skitzo2000/cyberdecks/backplane/a7s_backplane_schematic_kicad.png

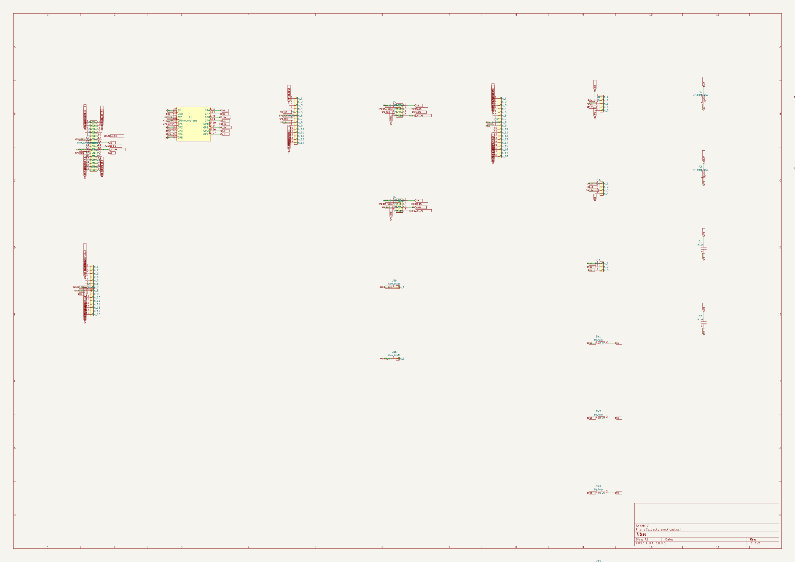
backplane/a7s_backplane_schematic_kicad.png
