skitzo2000/cyberdecks/backplane/kicad/renders/placement_current.png

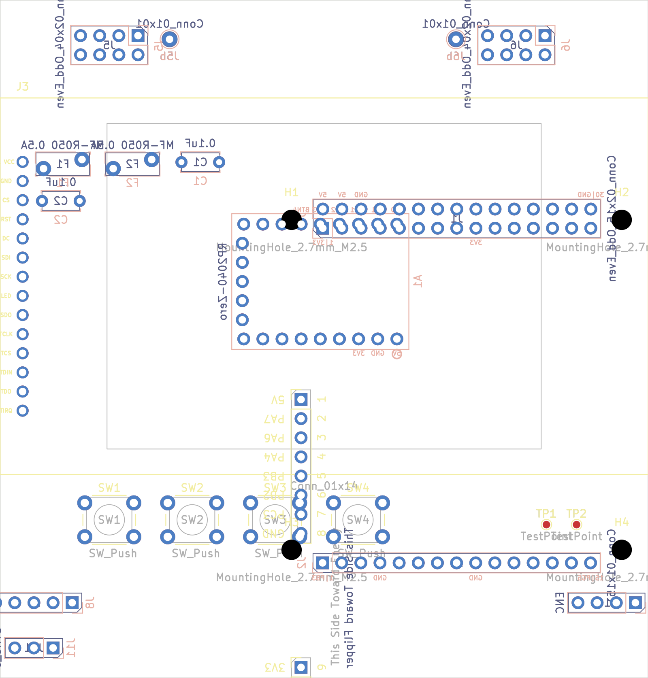
backplane/kicad/renders/placement_current.png
