skitzo2000/cyberdecks/backplane/kicad/renders/routed_bottom.png

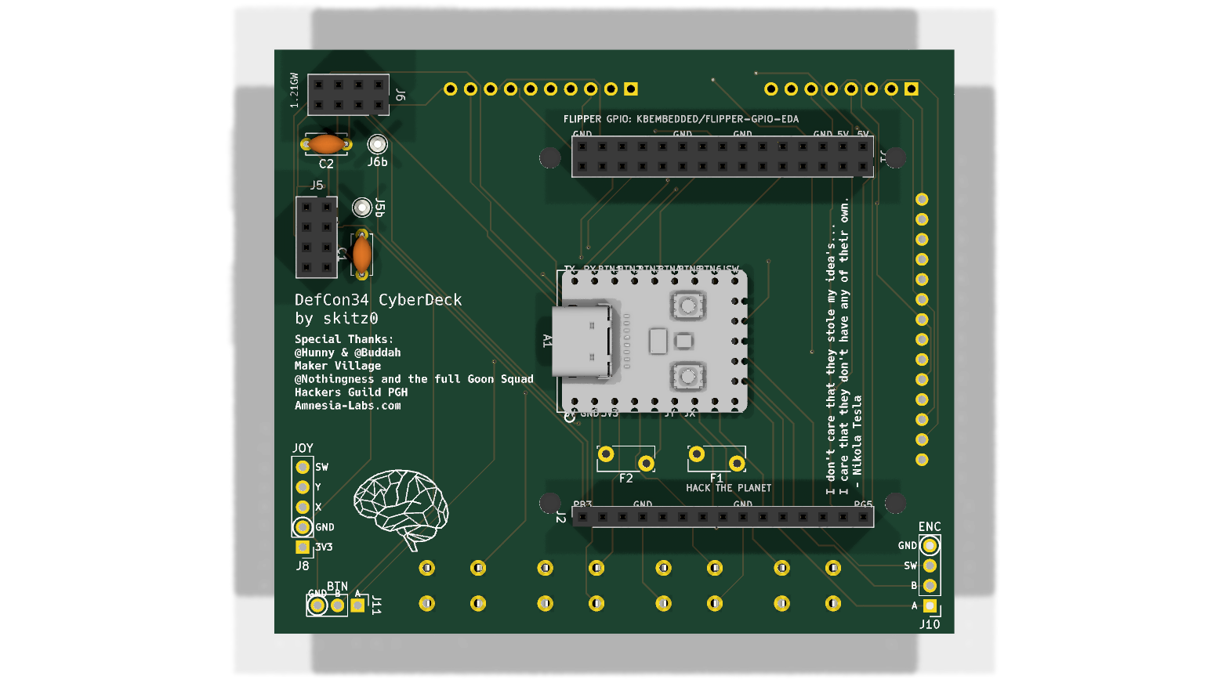
backplane/kicad/renders/routed_bottom.png
