skitzo2000/cyberdecks/backplane/kicad/renders/routed_top.png

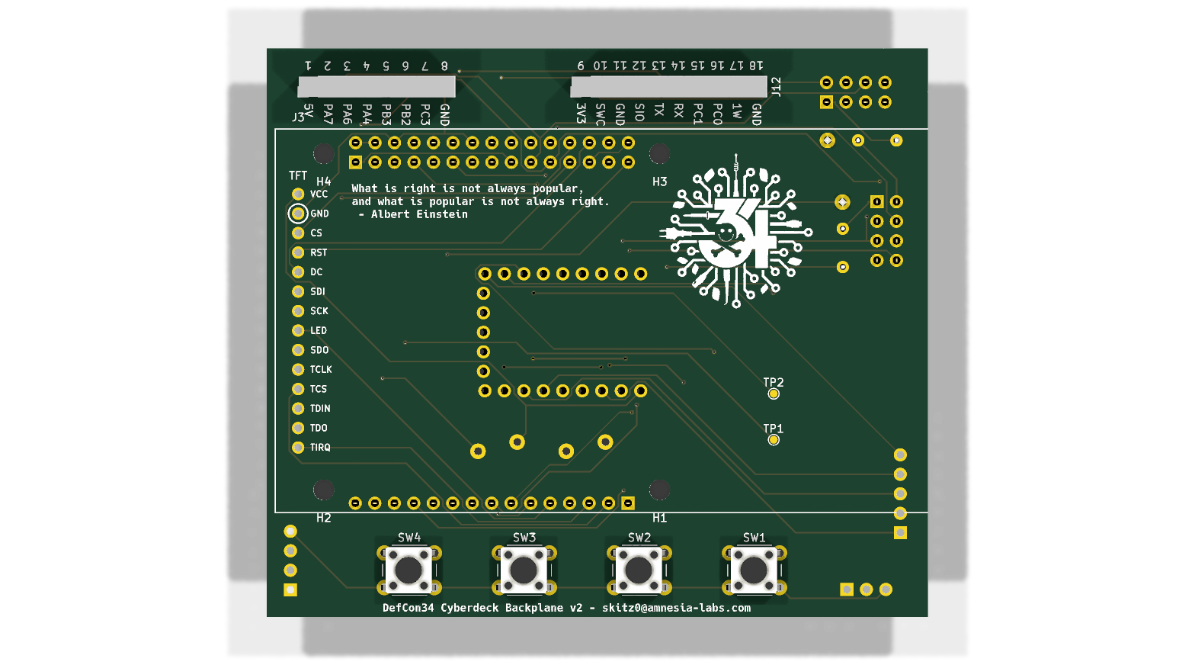
backplane/kicad/renders/routed_top.png
