skitzo2000/cyberdecks/backplane/v1/kicad/fab_rev2/a7s_backplane_rev2-schematic.png

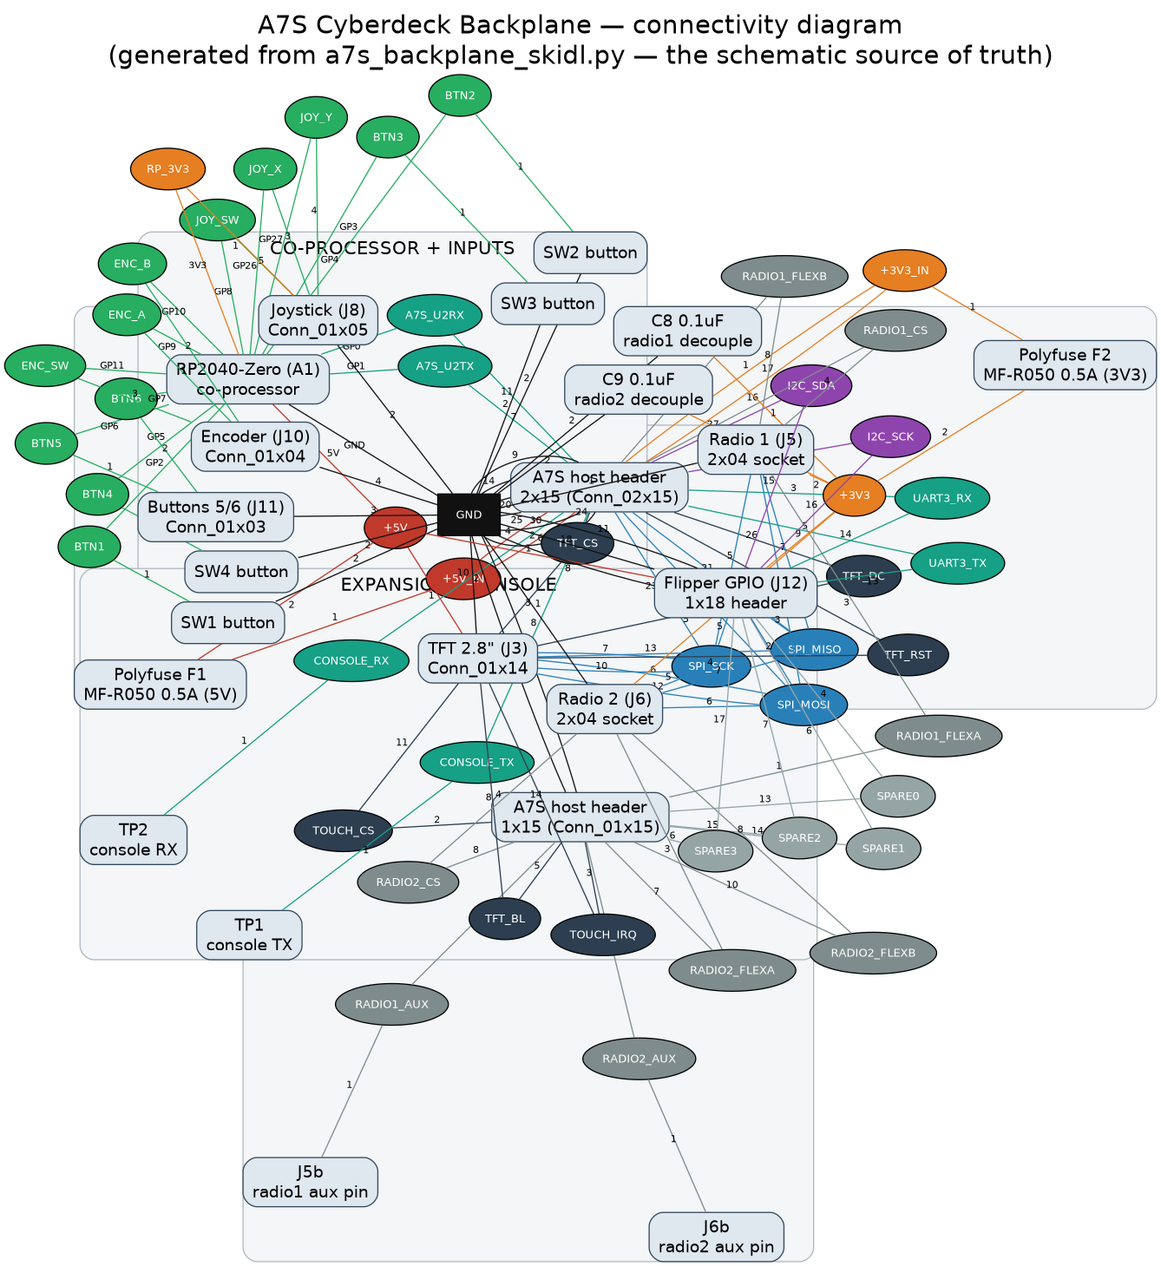
backplane/v1/kicad/fab_rev2/a7s_backplane_rev2-schematic.png
