skitzo2000/cyberdecks/backplane/a7s_backplane_schematic_kicad.pdf

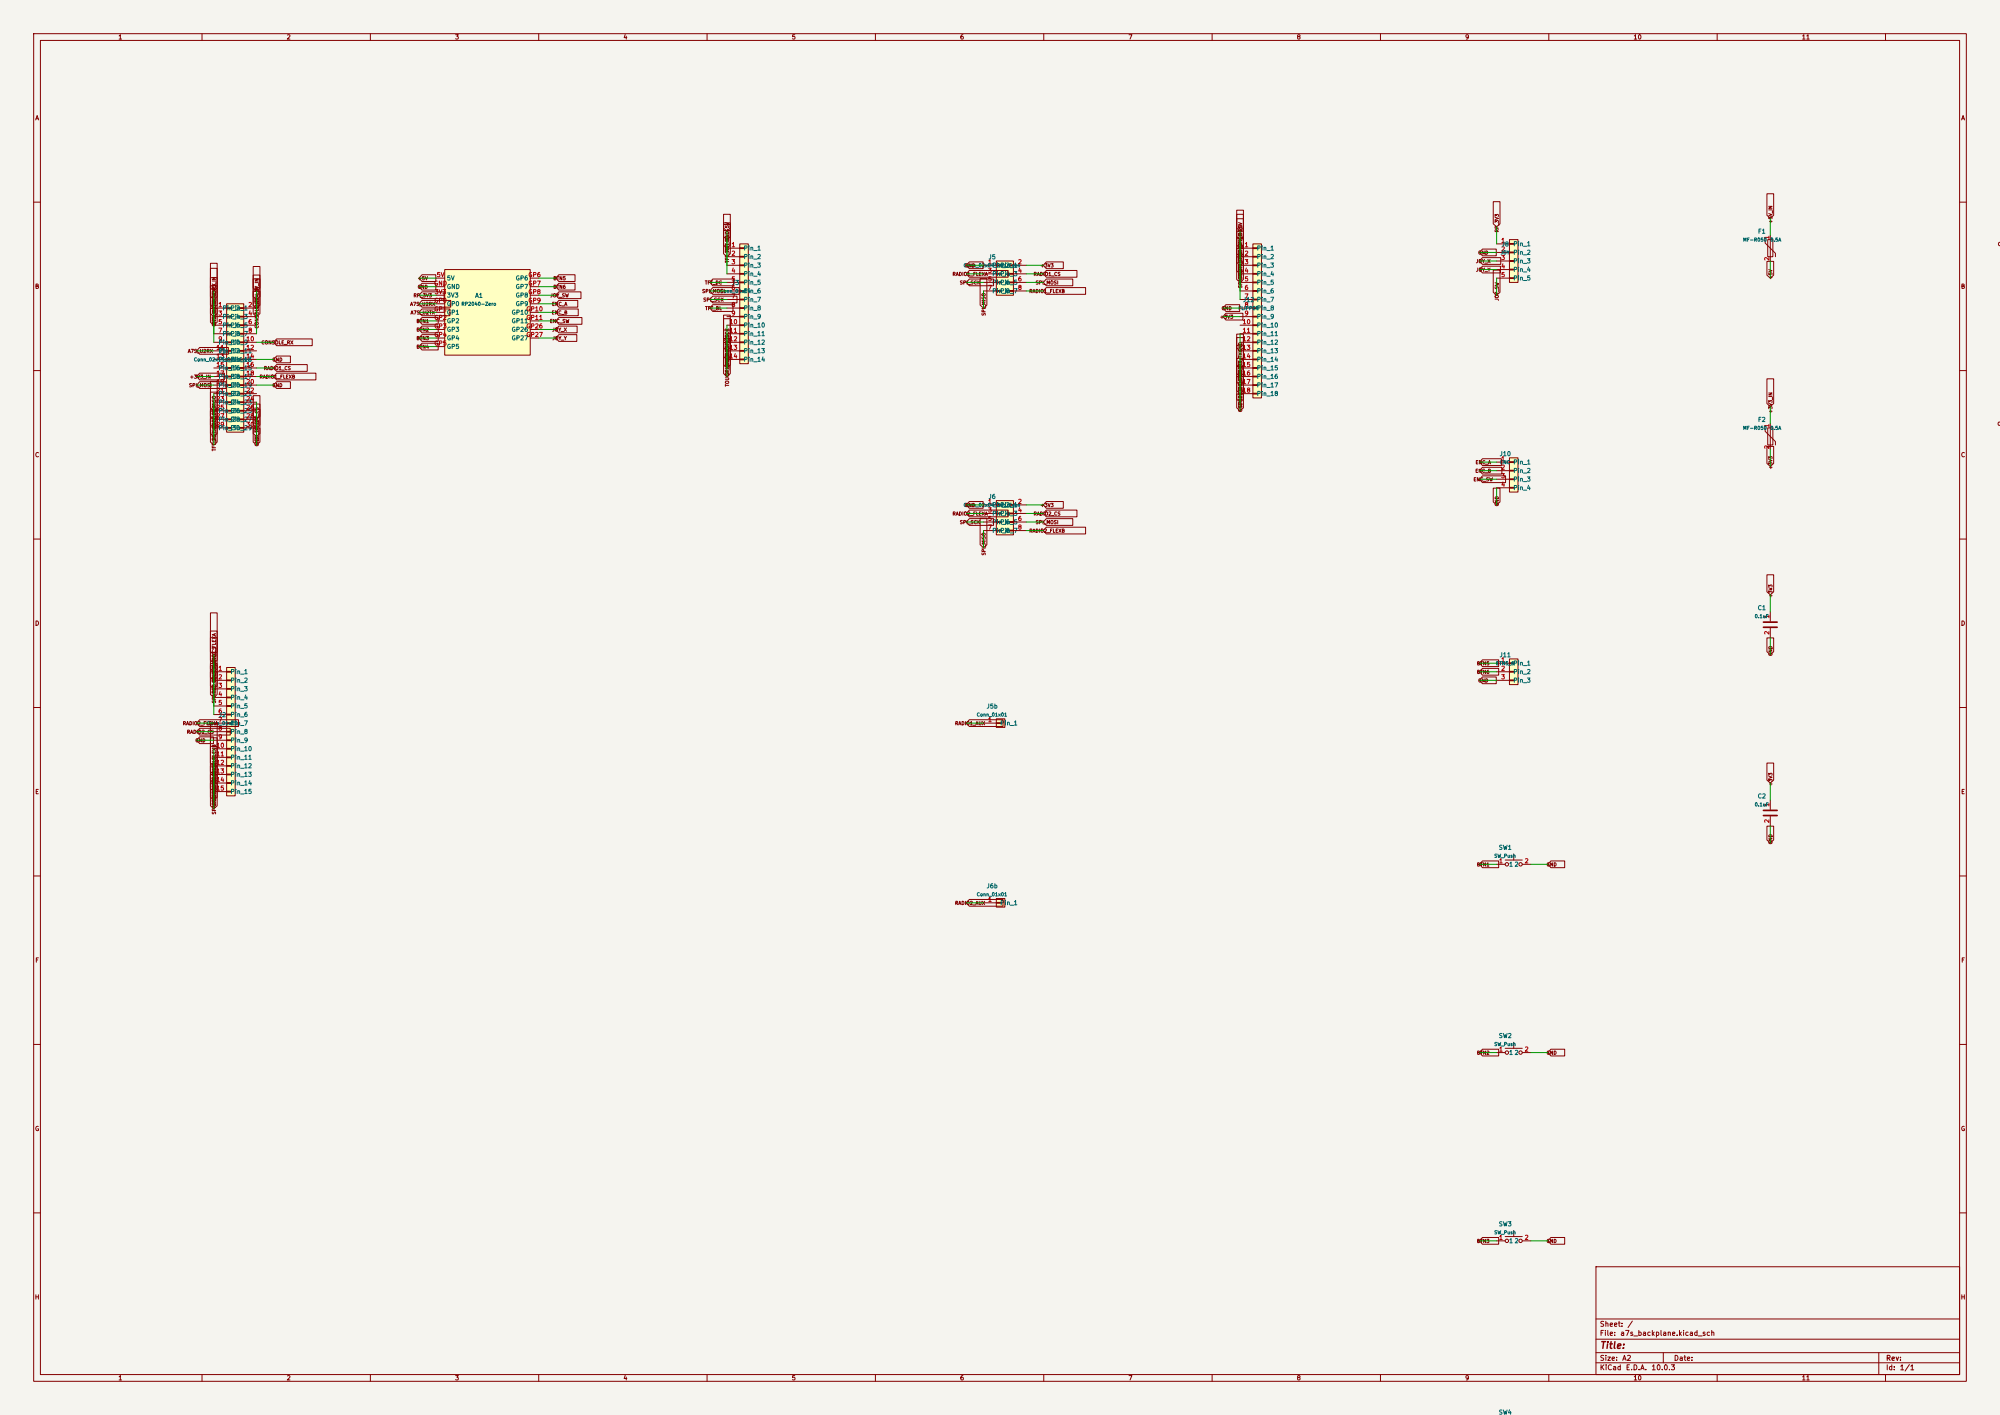
[picture p8: page 1]

Size: A2 | Rev:
KiCad E.D.A. 10.0.3 | Id: 1/1
