skitzo2000/cyberdecks/backplane/v1/kicad/fab_rev2/a7s_backplane_rev2-schematic.pdf

## A7S Cyberdeck Backplane — connectivity diagram (generated from a7s_backplane_skidl.py — the schematic source of truth)

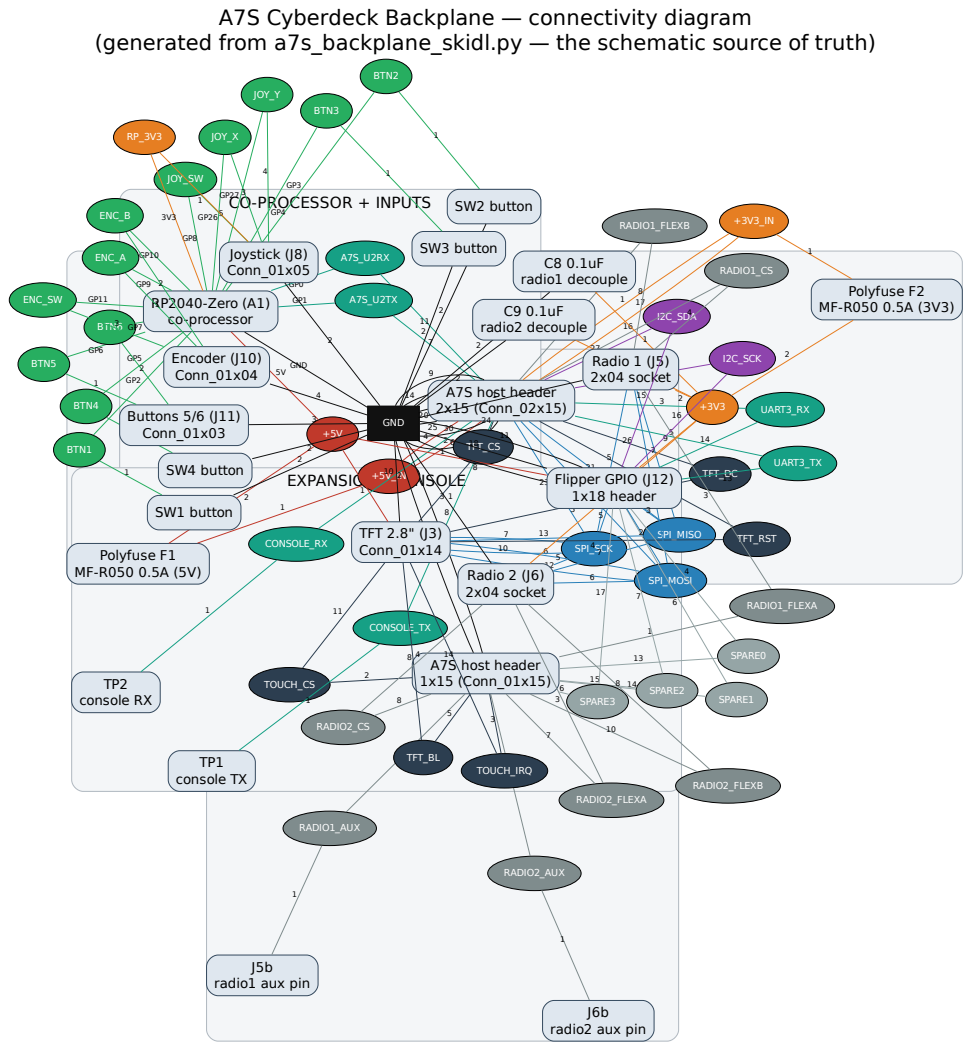
[picture p9: page 1]
