skitzo2000/cyberdecks/backplane/v1/kicad/fab_rev2/a7s_backplane_rev2-fab.pdf

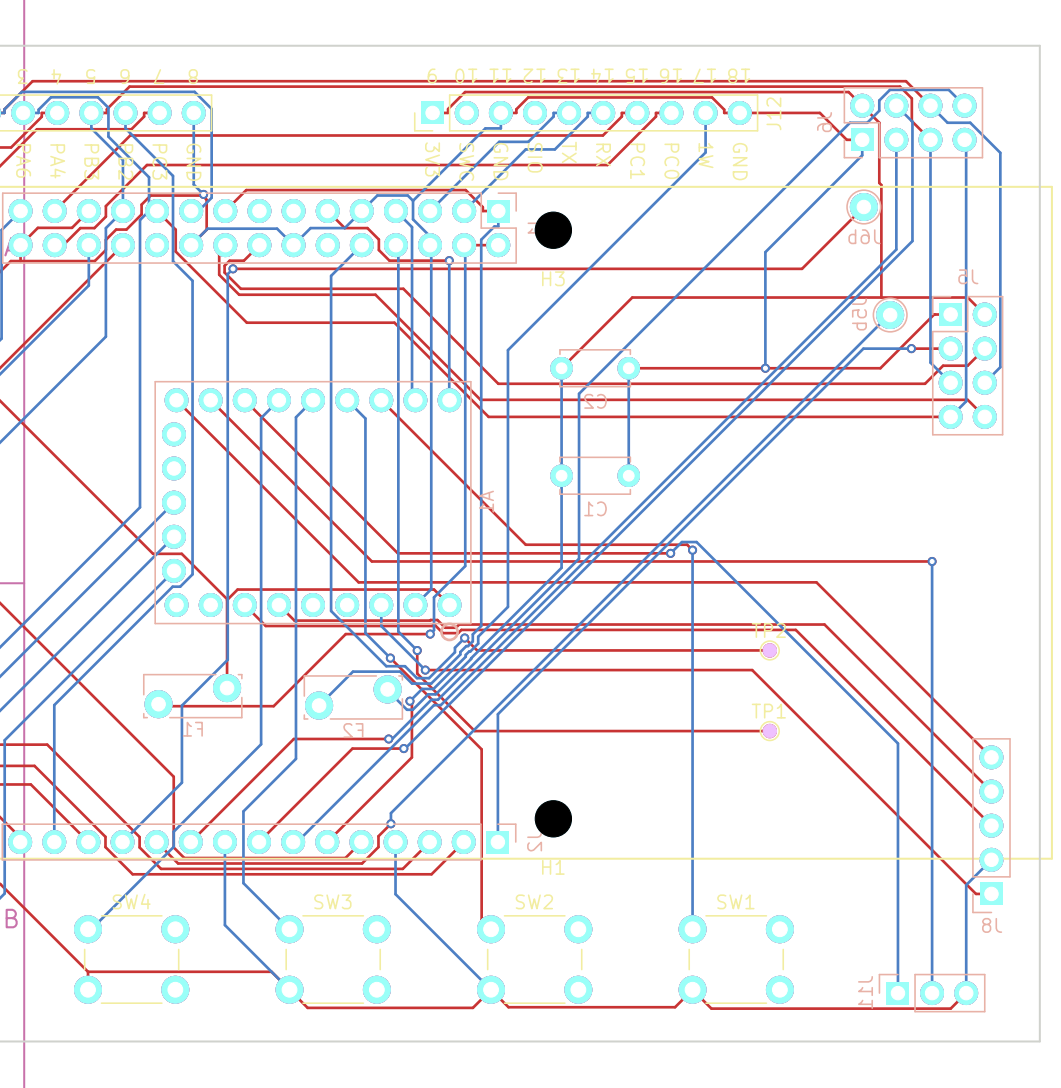
[picture p10: page 1]

Size: A4 | Rev:
KiCad E.D.A. 10.0.3 | Id: 1/1
