skitzo2000/cyberdecks/backplane/kicad/a7s_backplane_routed.kicad_pcb

## KiCad design backplane/kicad/a7s_backplane_routed.kicad_pcb (2026-07-12)

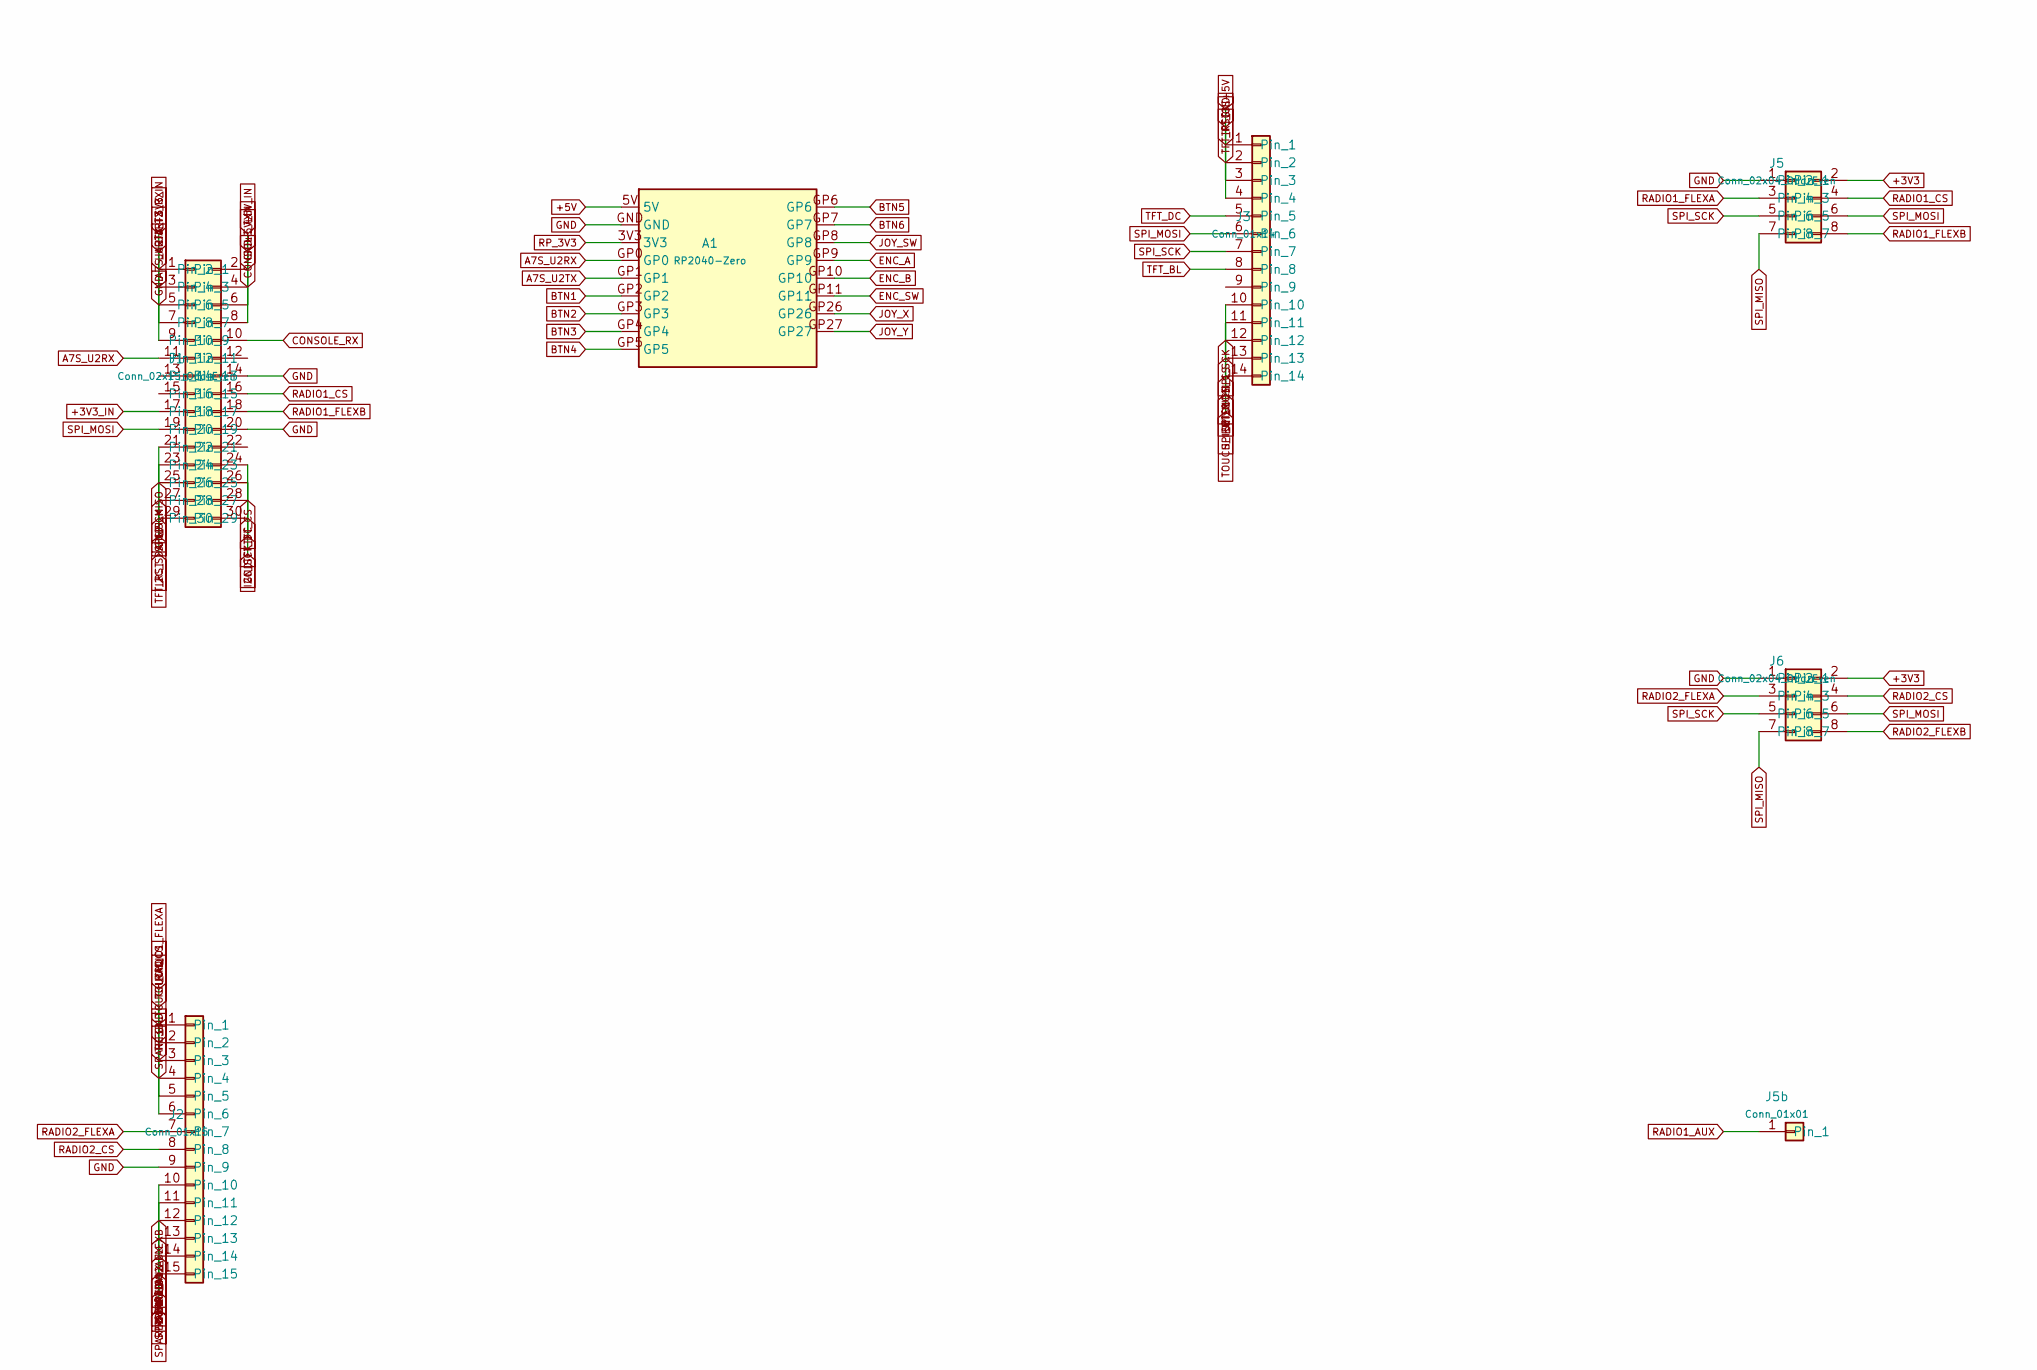
[picture p11: schematic a7s_backplane.kicad_sch, part in row 1, column 1]

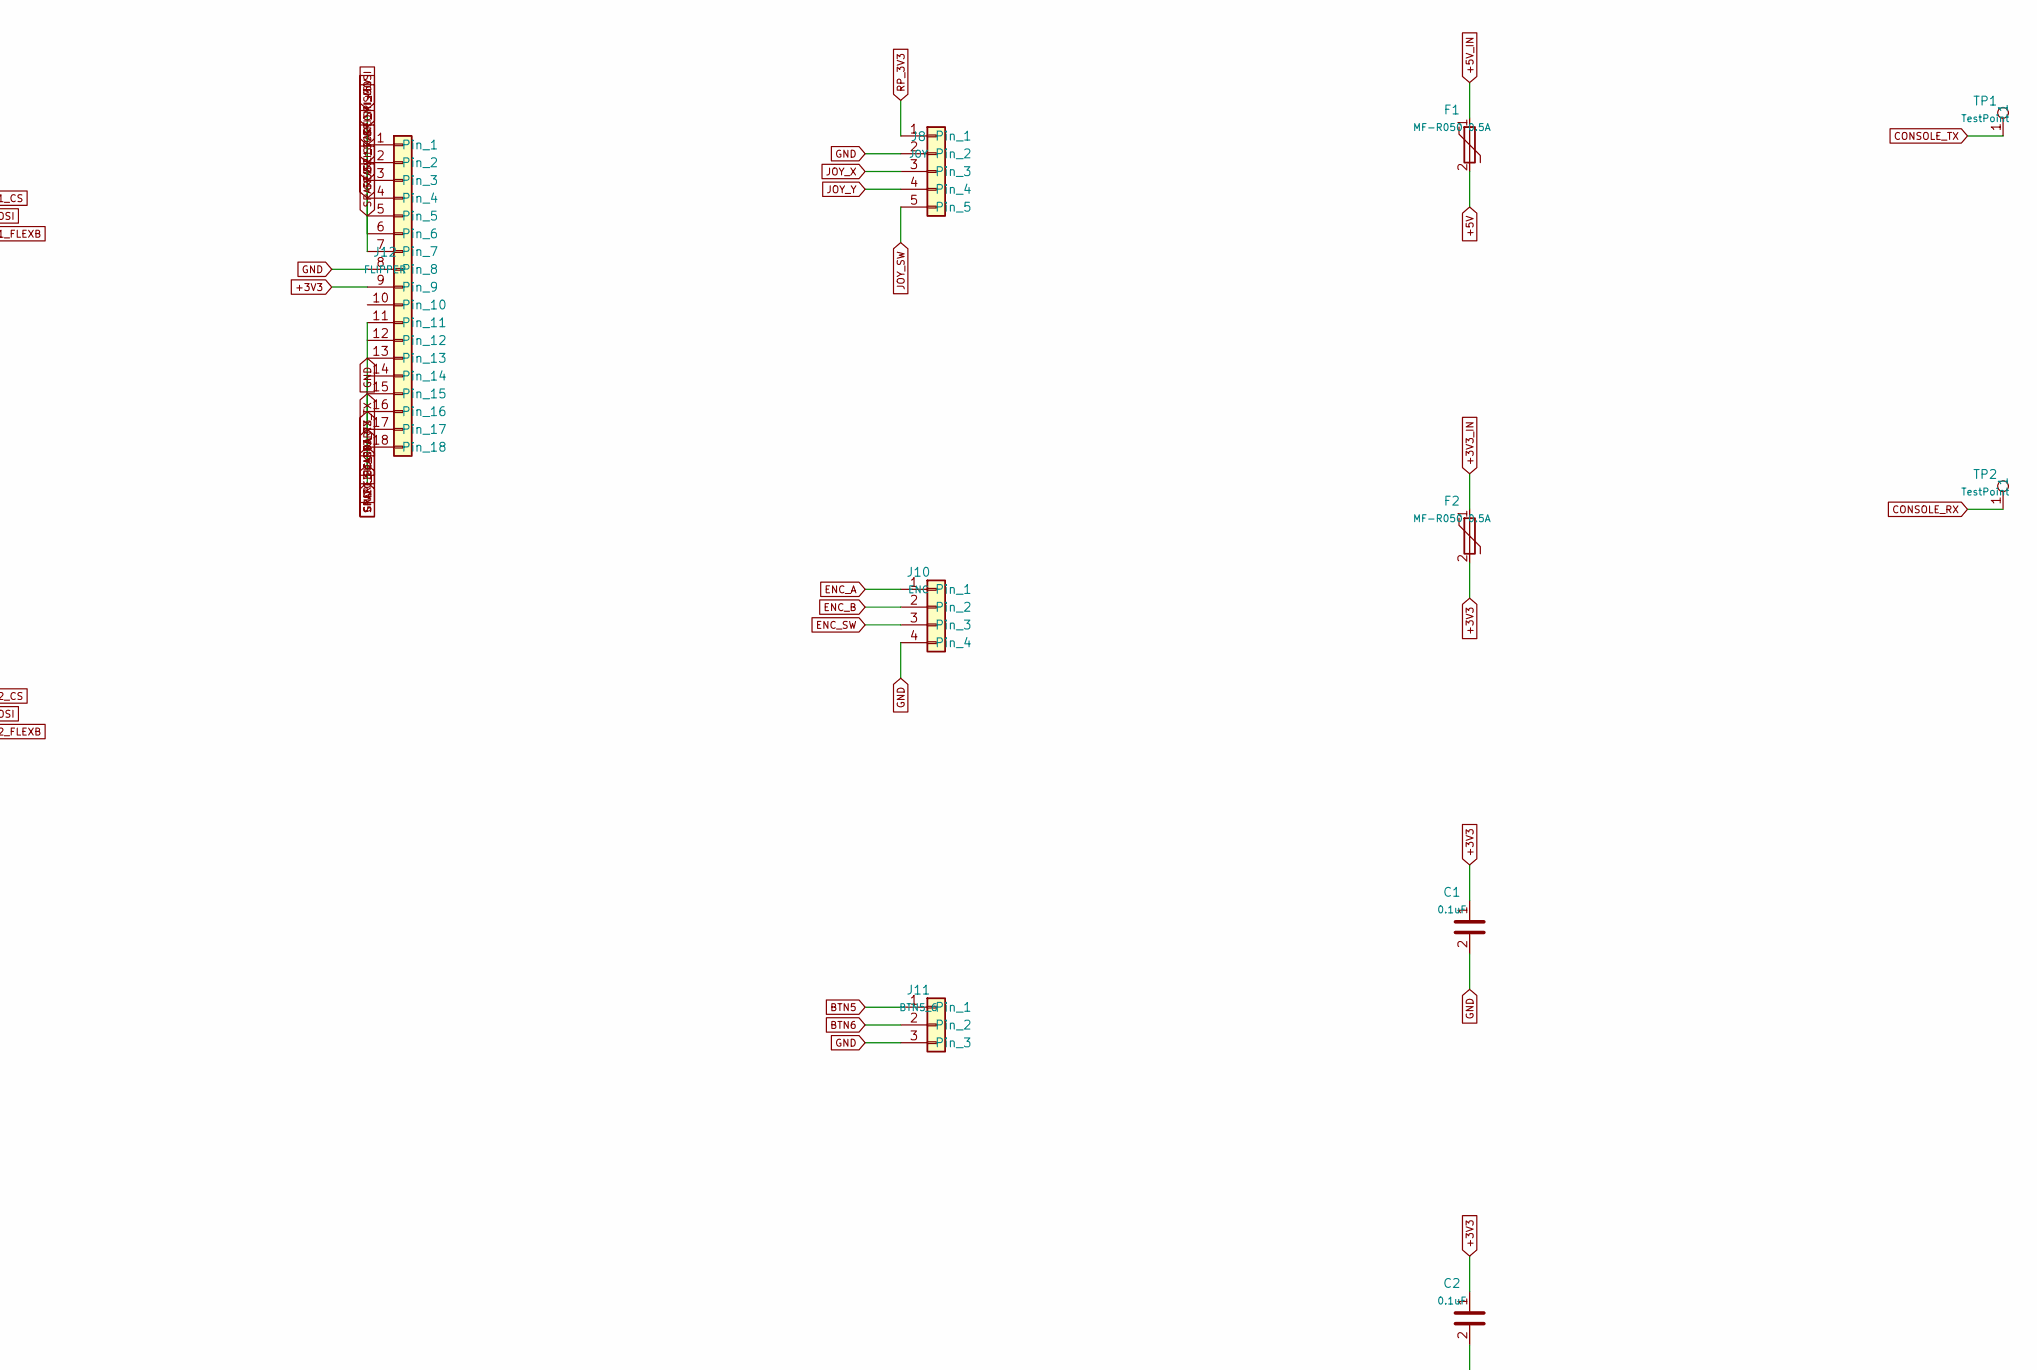
[picture p12: schematic a7s_backplane.kicad_sch, part in row 1, column 2]

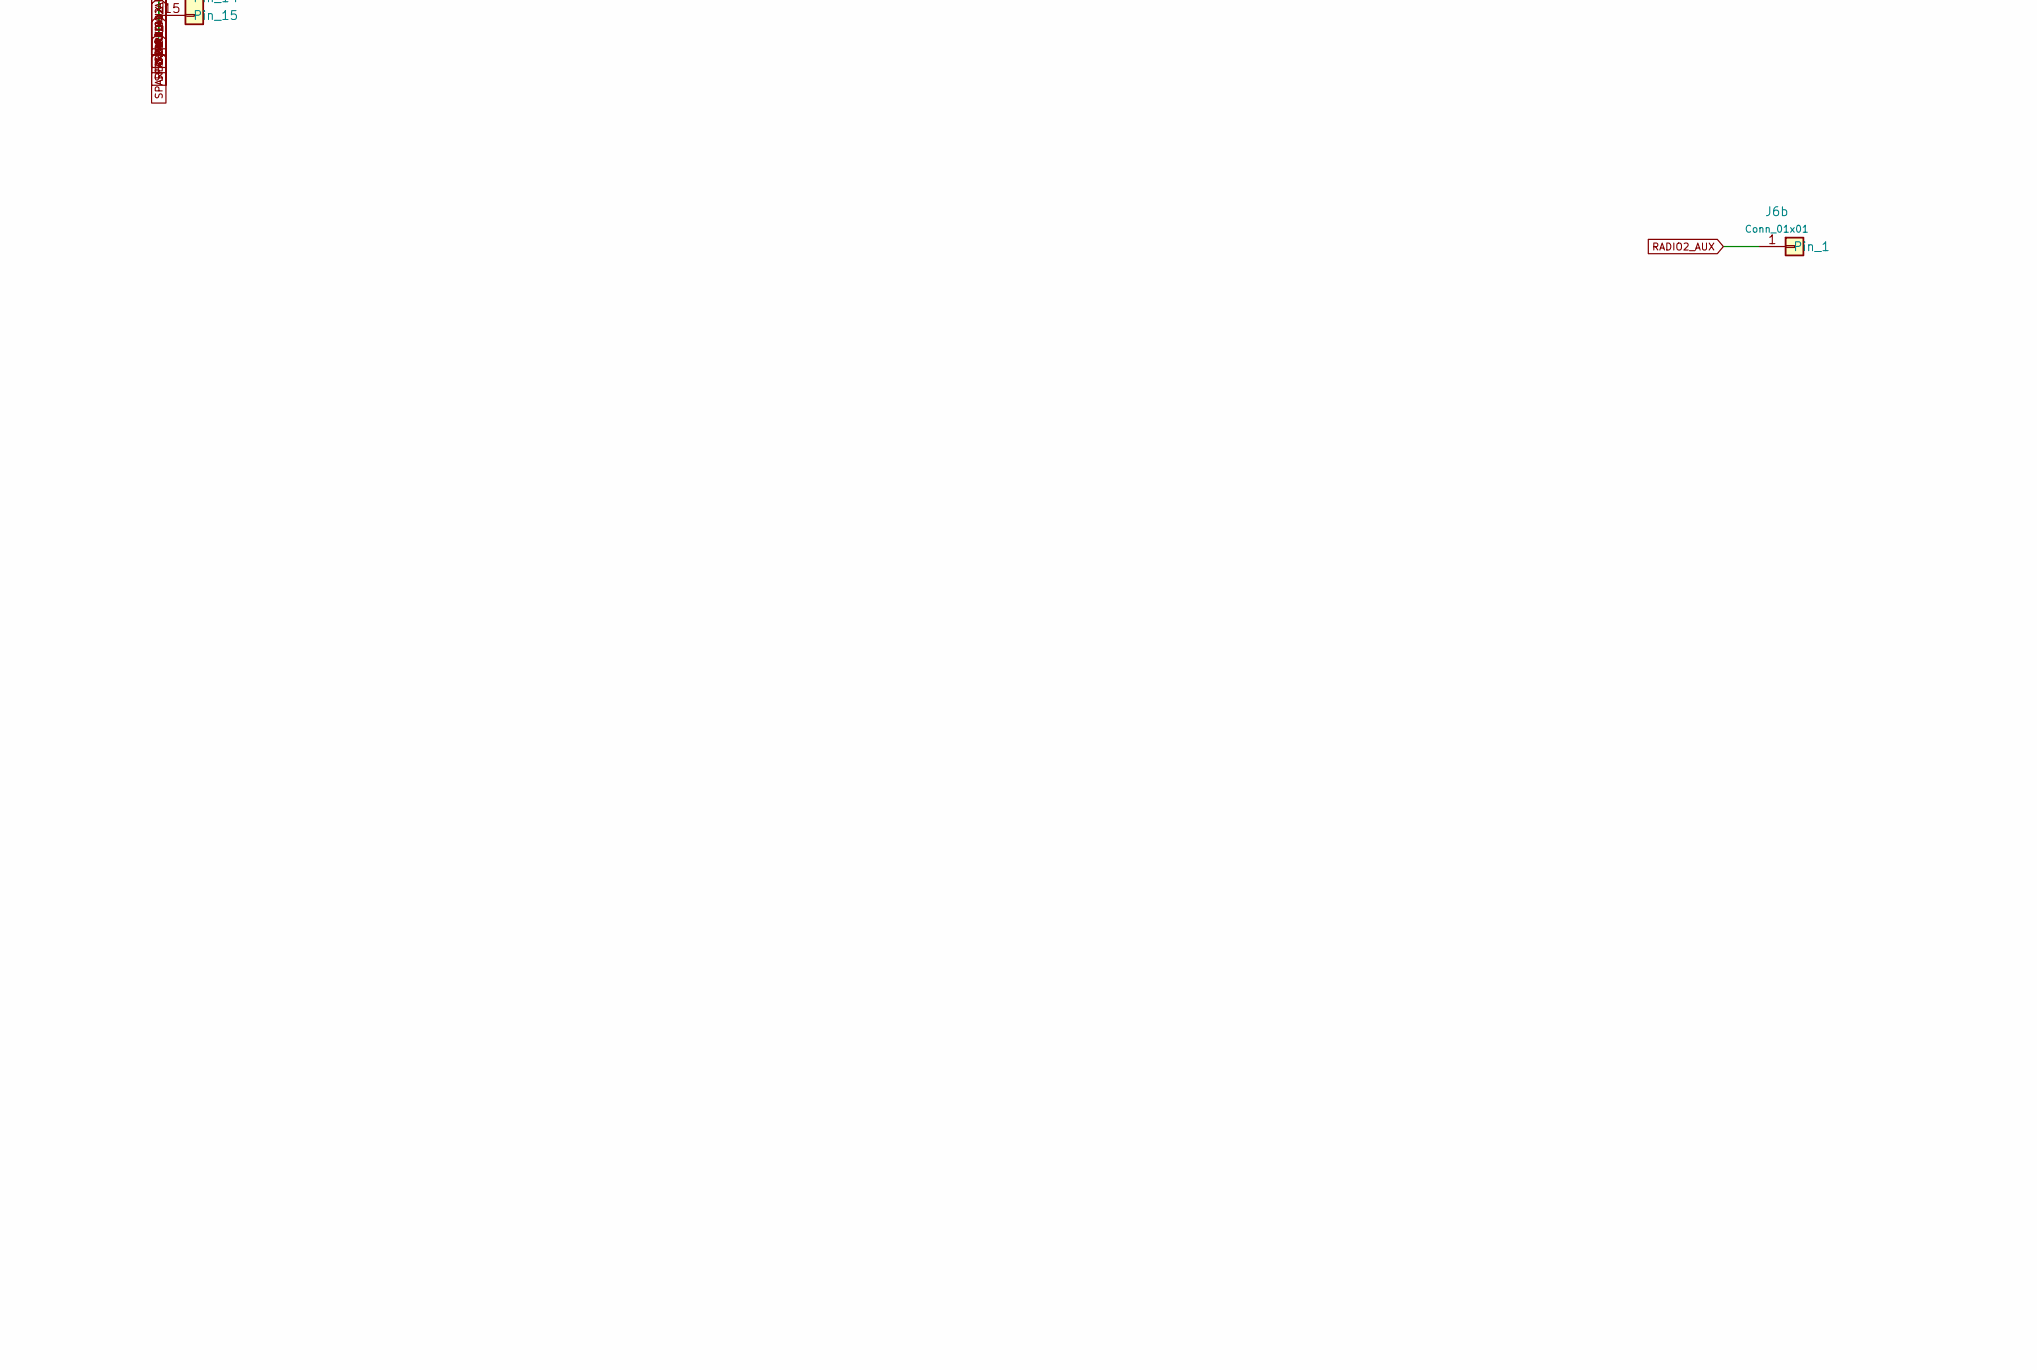
[picture p13: schematic a7s_backplane.kicad_sch, part in row 2, column 1]

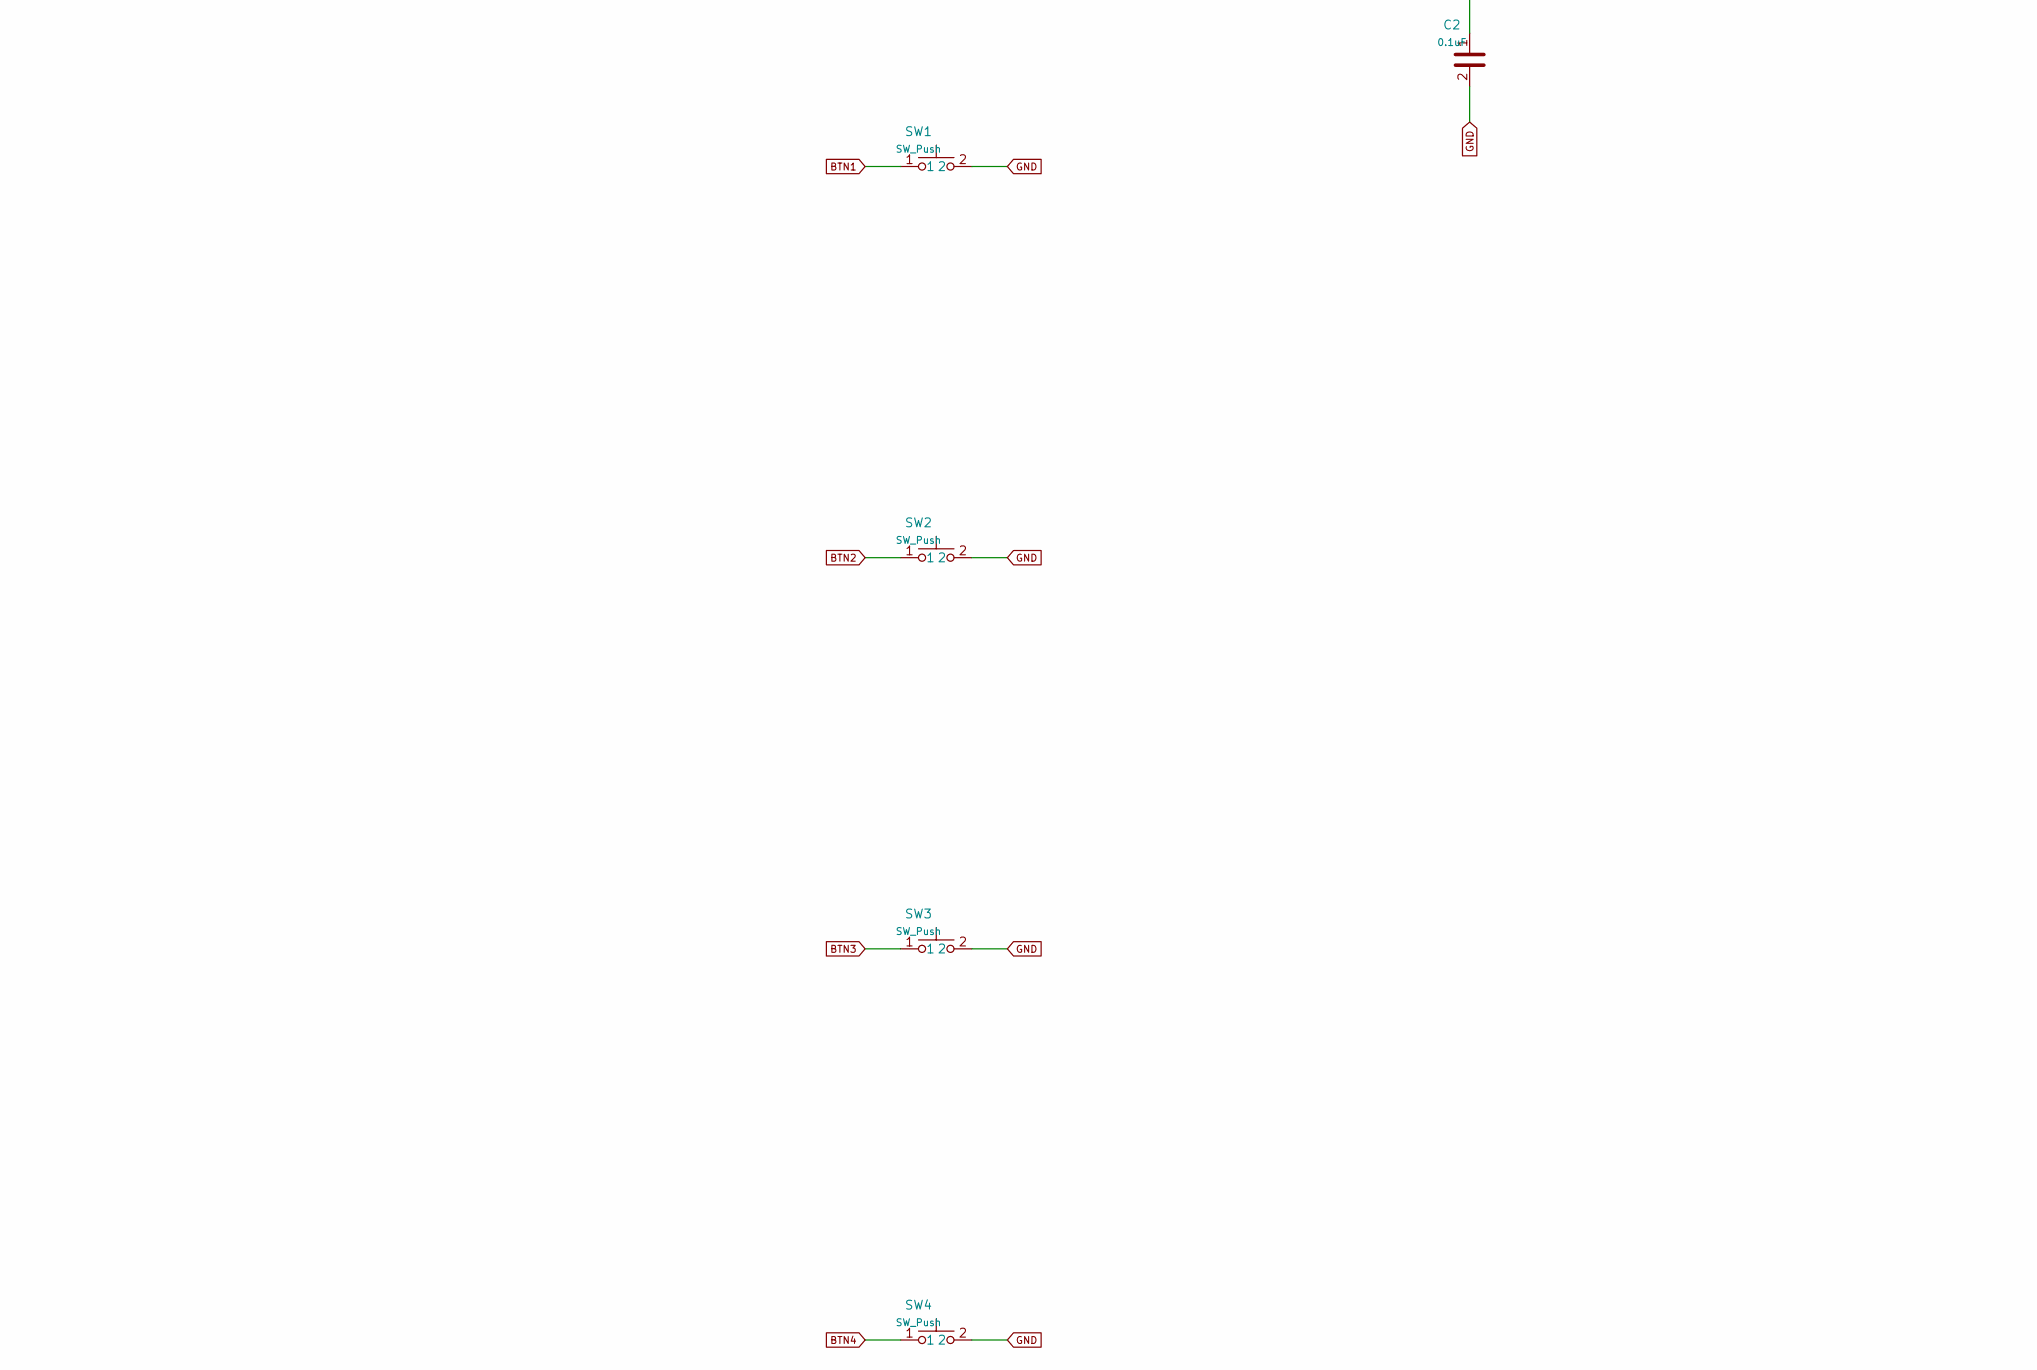
[picture p14: schematic a7s_backplane.kicad_sch, part in row 2, column 2]

Parts:
A1: RP2040-Zero
C1, C2: 0.1uF
F1, F2: MF-R050 0.5A
J1: Conn_02x15_Odd_Even
J2: Conn_01x15
J3: Conn_01x14
J5, J6: Conn_02x04_Odd_Even
J5b, J6b: Conn_01x01
J8: JOY
J10: ENC
J11: BTN5_6
J12: FLIPPER
SW1, SW2, SW3, SW4: SW_Push
TP1, TP2: TestPoint

Connections:
+3V3: C1.1, C2.1, F2.2, J5.2, J6.2, J12.9
A7S_U2RX: A1.GP0, J1.11
BTN1: A1.GP2, SW1.1
BTN2: A1.GP3, SW2.1
BTN3: A1.GP4, SW3.1
BTN4: A1.GP5, SW4.1
BTN5: A1.GP6, J11.1
BTN6: A1.GP7, J11.2
CONSOLE_RX: J1.10, TP2.1
ENC_A: A1.GP9, J10.1
ENC_B: A1.GP10, J10.2
ENC_SW: A1.GP11, J10.3
JOY_SW: A1.GP8, J8.5
JOY_X: A1.GP26, J8.3
JOY_Y: A1.GP27, J8.4
RADIO1_CS: J1.16, J5.4
RADIO1_FLEXB: J1.18, J5.8
RADIO2_CS: J2.8, J6.4
RADIO2_FLEXA: J2.7, J6.3
RP_3V3: A1.3V3, J8.1

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
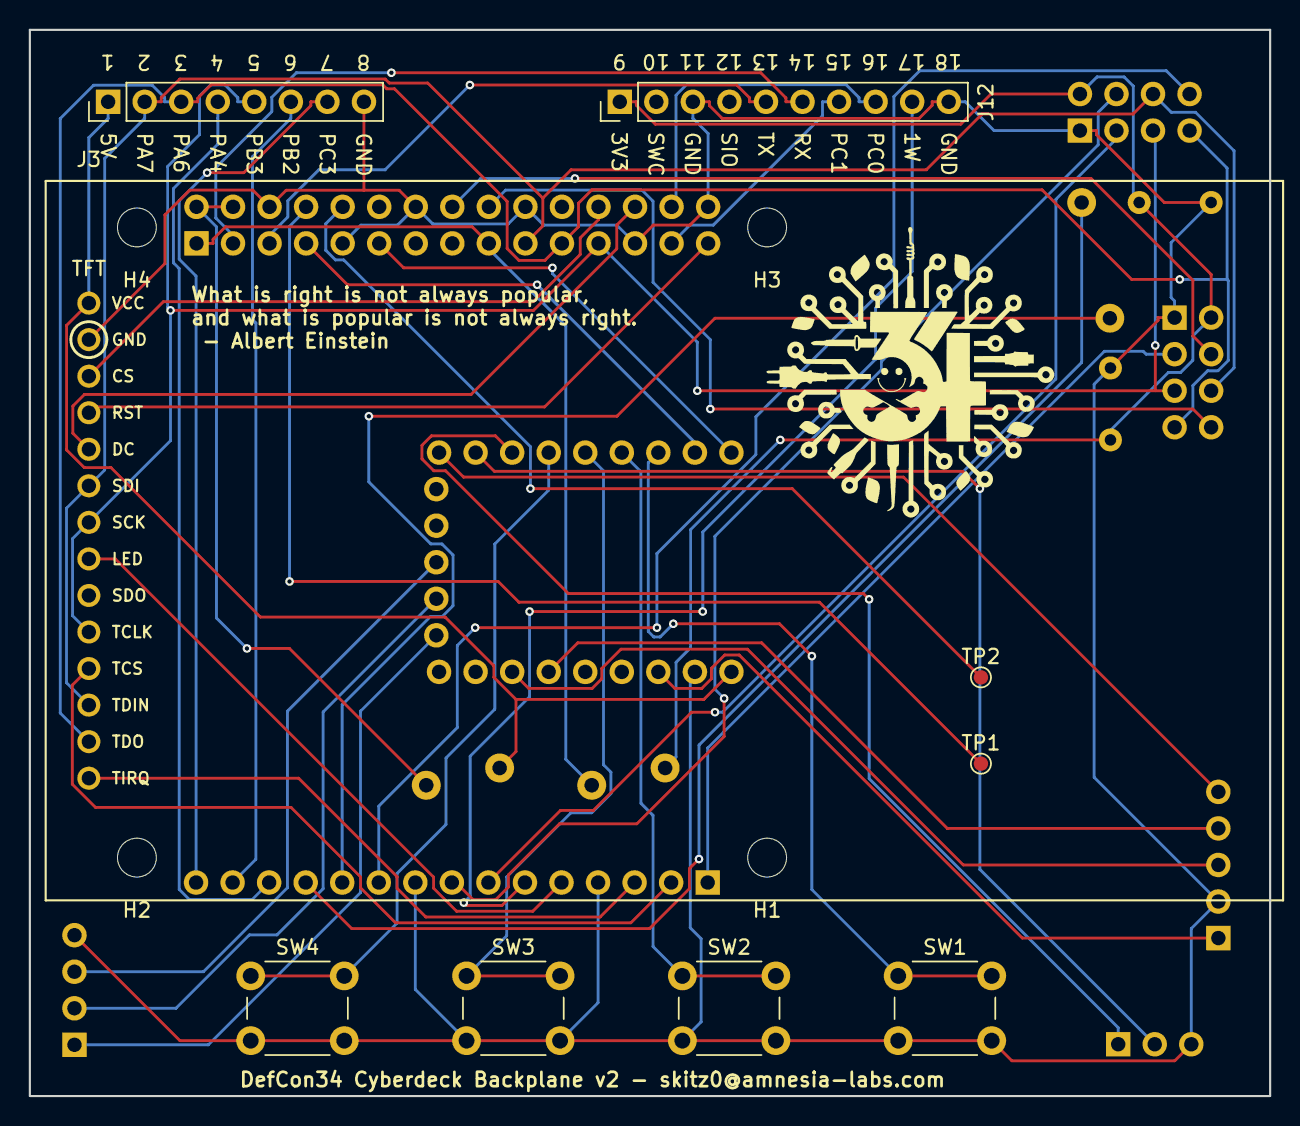
[picture p15: board a7s_backplane_routed.kicad_pcb from above]

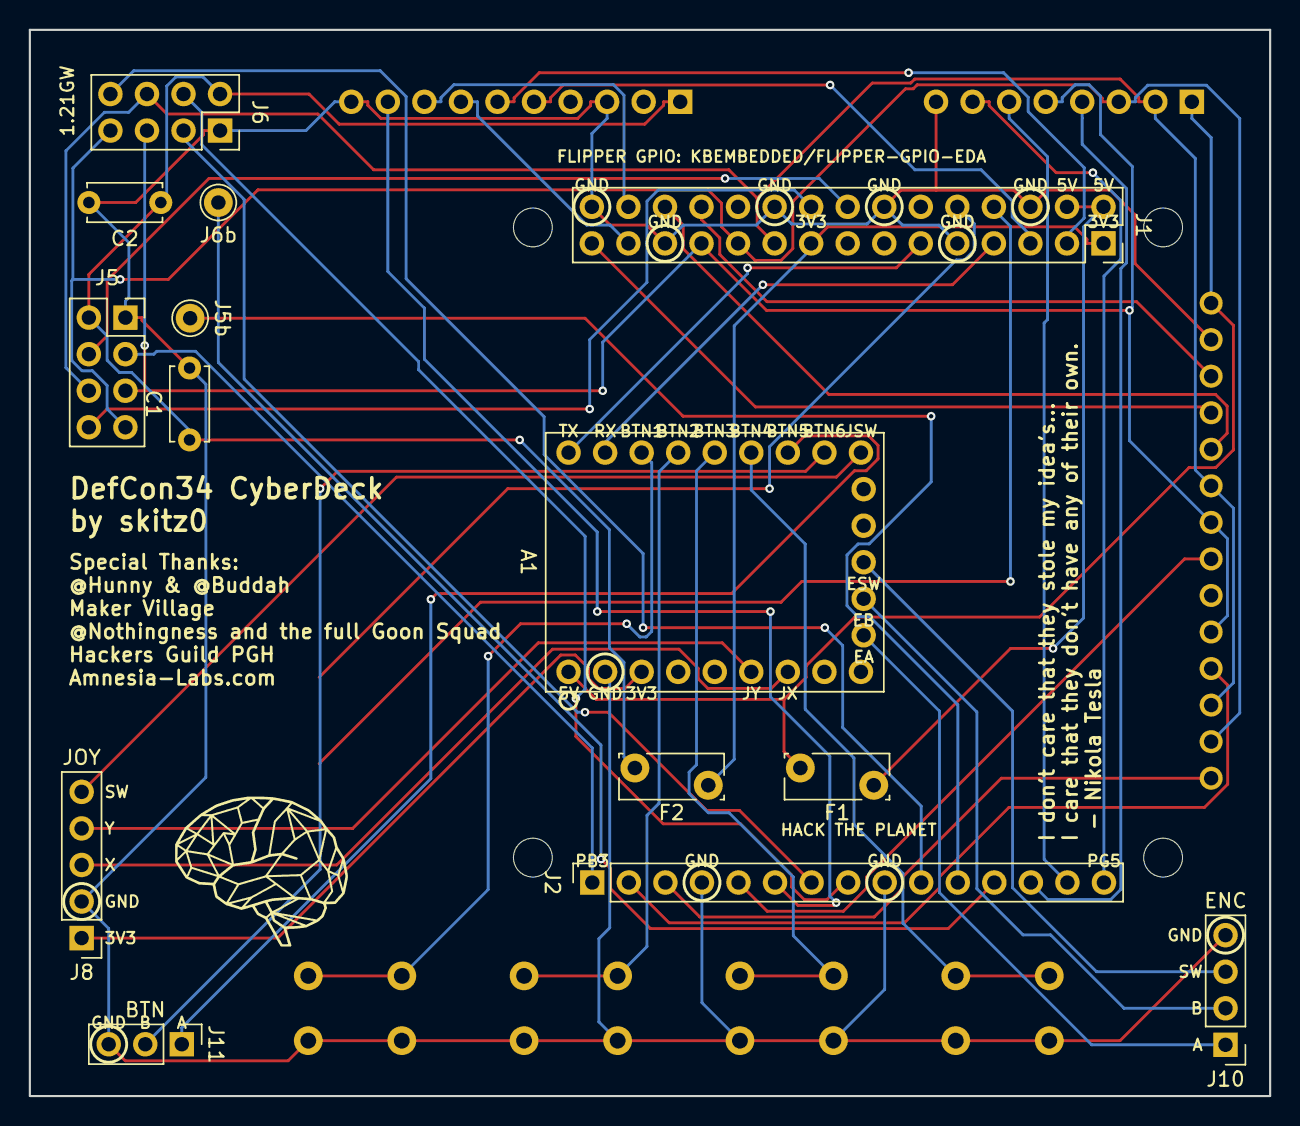
[picture p16: board a7s_backplane_routed.kicad_pcb from below]

Board: 2 copper layers, 86.2 x 74.1 mm, 26 parts (14 on the bottom side), 47 nets.

Other parts of the board:
H1, H2, H3, H4: MountingHole_2.7mm_M2.5
