skitzo2000/cyberdecks/backplane/a7s_backplane_skidl_sklib.py

from collections import defaultdict
from skidl import Pin, Part, Alias, SchLib, SKIDL, TEMPLATE

from skidl.pin import pin_types

SKIDL_lib_version = '0.0.1'

a7s_backplane_skidl = SchLib(tool=SKIDL).add_parts(*[
        Part(**{ 'name':'Conn_02x15_Odd_Even', 'dest':TEMPLATE, 'tool':SKIDL, 'aliases':Alias({'Conn_02x15_Odd_Even'}), 'ref_prefix':'J', 'fplist':[''], 'footprint':'Connector_PinSocket_2.54mm:PinSocket_2x15_P2.54mm_Vertical', 'keywords':'connector', 'description':'Generic connector, double row, 02x15, odd/even pin numbering scheme (row 1 odd numbers, row 2 even numbers), script generated (kicad-library-utils/schlib/autogen/connector/)', 'datasheet':'~', 'pins':[
            Pin(num='1',name='Pin_1',func=pin_types.PASSIVE,unit=1),
            Pin(num='10',name='Pin_10',func=pin_types.PASSIVE,unit=1),
            Pin(num='11',name='Pin_11',func=pin_types.PASSIVE,unit=1),
            Pin(num='12',name='Pin_12',func=pin_types.PASSIVE,unit=1),
            Pin(num='13',name='Pin_13',func=pin_types.PASSIVE,unit=1),
            Pin(num='14',name='Pin_14',func=pin_types.PASSIVE,unit=1),
            Pin(num='15',name='Pin_15',func=pin_types.PASSIVE,unit=1),
            Pin(num='16',name='Pin_16',func=pin_types.PASSIVE,unit=1),
            Pin(num='17',name='Pin_17',func=pin_types.PASSIVE,unit=1),
            Pin(num='18',name='Pin_18',func=pin_types.PASSIVE,unit=1),
            Pin(num='19',name='Pin_19',func=pin_types.PASSIVE,unit=1),
            Pin(num='2',name='Pin_2',func=pin_types.PASSIVE,unit=1),
            Pin(num='20',name='Pin_20',func=pin_types.PASSIVE,unit=1),
            Pin(num='21',name='Pin_21',func=pin_types.PASSIVE,unit=1),
            Pin(num='22',name='Pin_22',func=pin_types.PASSIVE,unit=1),
            Pin(num='23',name='Pin_23',func=pin_types.PASSIVE,unit=1),
            Pin(num='24',name='Pin_24',func=pin_types.PASSIVE,unit=1),
            Pin(num='25',name='Pin_25',func=pin_types.PASSIVE,unit=1),
            Pin(num='26',name='Pin_26',func=pin_types.PASSIVE,unit=1),
            Pin(num='27',name='Pin_27',func=pin_types.PASSIVE,unit=1),
            Pin(num='28',name='Pin_28',func=pin_types.PASSIVE,unit=1),
            Pin(num='29',name='Pin_29',func=pin_types.PASSIVE,unit=1),
            Pin(num='3',name='Pin_3',func=pin_types.PASSIVE,unit=1),
            Pin(num='30',name='Pin_30',func=pin_types.PASSIVE,unit=1),
            Pin(num='4',name='Pin_4',func=pin_types.PASSIVE,unit=1),
            Pin(num='5',name='Pin_5',func=pin_types.PASSIVE,unit=1),
            Pin(num='6',name='Pin_6',func=pin_types.PASSIVE,unit=1),
            Pin(num='7',name='Pin_7',func=pin_types.PASSIVE,unit=1),
            Pin(num='8',name='Pin_8',func=pin_types.PASSIVE,unit=1),
            Pin(num='9',name='Pin_9',func=pin_types.PASSIVE,unit=1)], 'unit_defs':[] }),
        Part(**{ 'name':'Conn_01x15', 'dest':TEMPLATE, 'tool':SKIDL, 'aliases':Alias({'Conn_01x15'}), 'ref_prefix':'J', 'fplist':[''], 'footprint':'Connector_PinSocket_2.54mm:PinSocket_1x15_P2.54mm_Vertical', 'keywords':'connector', 'description':'Generic connector, single row, 01x15, script generated (kicad-library-utils/schlib/autogen/connector/)', 'datasheet':'~', 'pins':[
            Pin(num='1',name='Pin_1',func=pin_types.PASSIVE,unit=1),
            Pin(num='10',name='Pin_10',func=pin_types.PASSIVE,unit=1),
            Pin(num='11',name='Pin_11',func=pin_types.PASSIVE,unit=1),
            Pin(num='12',name='Pin_12',func=pin_types.PASSIVE,unit=1),
            Pin(num='13',name='Pin_13',func=pin_types.PASSIVE,unit=1),
            Pin(num='14',name='Pin_14',func=pin_types.PASSIVE,unit=1),
            Pin(num='15',name='Pin_15',func=pin_types.PASSIVE,unit=1),
            Pin(num='2',name='Pin_2',func=pin_types.PASSIVE,unit=1),
            Pin(num='3',name='Pin_3',func=pin_types.PASSIVE,unit=1),
            Pin(num='4',name='Pin_4',func=pin_types.PASSIVE,unit=1),
            Pin(num='5',name='Pin_5',func=pin_types.PASSIVE,unit=1),
            Pin(num='6',name='Pin_6',func=pin_types.PASSIVE,unit=1),
            Pin(num='7',name='Pin_7',func=pin_types.PASSIVE,unit=1),
            Pin(num='8',name='Pin_8',func=pin_types.PASSIVE,unit=1),
            Pin(num='9',name='Pin_9',func=pin_types.PASSIVE,unit=1)], 'unit_defs':[] }),
        Part(**{ 'name':'Polyfuse', 'dest':TEMPLATE, 'tool':SKIDL, 'aliases':Alias({'Polyfuse'}), 'ref_prefix':'F', 'fplist':[''], 'footprint':'Fuse:Fuse_Bourns_MF-RG300', 'keywords':'resettable fuse PTC PPTC polyfuse polyswitch', 'description':'Resettable fuse, polymeric positive temperature coefficient', 'datasheet':'~', 'pins':[
            Pin(num='1',name='~',func=pin_types.PASSIVE,unit=1),
            Pin(num='2',name='~',func=pin_types.PASSIVE,unit=1)], 'unit_defs':[] }),
        Part(**{ 'name':'C', 'dest':TEMPLATE, 'tool':SKIDL, 'aliases':Alias({'C'}), 'ref_prefix':'C', 'fplist':[''], 'footprint':'Capacitor_THT:C_Disc_D5.0mm_W2.5mm_P5.00mm', 'keywords':'cap capacitor', 'description':'Unpolarized capacitor', 'datasheet':'~', 'pins':[
            Pin(num='1',name='~',func=pin_types.PASSIVE,unit=1),
            Pin(num='2',name='~',func=pin_types.PASSIVE,unit=1)], 'unit_defs':[] }),
        Part(**{ 'name':'Conn_01x14', 'dest':TEMPLATE, 'tool':SKIDL, 'aliases':Alias({'Conn_01x14'}), 'ref_prefix':'J', 'fplist':[''], 'footprint':'a7s:TFT_2p8', 'keywords':'connector', 'description':'Generic connector, single row, 01x14, script generated (kicad-library-utils/schlib/autogen/connector/)', 'datasheet':'~', 'pins':[
            Pin(num='1',name='Pin_1',func=pin_types.PASSIVE,unit=1),
            Pin(num='10',name='Pin_10',func=pin_types.PASSIVE,unit=1),
            Pin(num='11',name='Pin_11',func=pin_types.PASSIVE,unit=1),
            Pin(num='12',name='Pin_12',func=pin_types.PASSIVE,unit=1),
            Pin(num='13',name='Pin_13',func=pin_types.PASSIVE,unit=1),
            Pin(num='14',name='Pin_14',func=pin_types.PASSIVE,unit=1),
            Pin(num='2',name='Pin_2',func=pin_types.PASSIVE,unit=1),
            Pin(num='3',name='Pin_3',func=pin_types.PASSIVE,unit=1),
            Pin(num='4',name='Pin_4',func=pin_types.PASSIVE,unit=1),
            Pin(num='5',name='Pin_5',func=pin_types.PASSIVE,unit=1),
            Pin(num='6',name='Pin_6',func=pin_types.PASSIVE,unit=1),
            Pin(num='7',name='Pin_7',func=pin_types.PASSIVE,unit=1),
            Pin(num='8',name='Pin_8',func=pin_types.PASSIVE,unit=1),
            Pin(num='9',name='Pin_9',func=pin_types.PASSIVE,unit=1)], 'unit_defs':[] }),
        Part(**{ 'name':'Conn_02x04_Odd_Even', 'dest':TEMPLATE, 'tool':SKIDL, 'aliases':Alias({'Conn_02x04_Odd_Even'}), 'ref_prefix':'J', 'fplist':[''], 'footprint':'Connector_PinSocket_2.54mm:PinSocket_2x04_P2.54mm_Vertical', 'keywords':'connector', 'description':'Generic connector, double row, 02x04, odd/even pin numbering scheme (row 1 odd numbers, row 2 even numbers), script generated (kicad-library-utils/schlib/autogen/connector/)', 'datasheet':'~', 'pins':[
            Pin(num='1',name='Pin_1',func=pin_types.PASSIVE,unit=1),
            Pin(num='2',name='Pin_2',func=pin_types.PASSIVE,unit=1),
            Pin(num='3',name='Pin_3',func=pin_types.PASSIVE,unit=1),
            Pin(num='4',name='Pin_4',func=pin_types.PASSIVE,unit=1),
            Pin(num='5',name='Pin_5',func=pin_types.PASSIVE,unit=1),
            Pin(num='6',name='Pin_6',func=pin_types.PASSIVE,unit=1),
            Pin(num='7',name='Pin_7',func=pin_types.PASSIVE,unit=1),
            Pin(num='8',name='Pin_8',func=pin_types.PASSIVE,unit=1)], 'unit_defs':[] }),
        Part(**{ 'name':'Conn_01x01', 'dest':TEMPLATE, 'tool':SKIDL, 'aliases':Alias({'Conn_01x01'}), 'ref_prefix':'J', 'fplist':[''], 'footprint':'Connector_Pin:Pin_D1.0mm_L10.0mm', 'keywords':'connector', 'description':'Generic connector, single row, 01x01, script generated (kicad-library-utils/schlib/autogen/connector/)', 'datasheet':'~', 'pins':[
            Pin(num='1',name='Pin_1',func=pin_types.PASSIVE,unit=1)], 'unit_defs':[] }),
        Part(**{ 'name':'RP2040_Zero', 'dest':TEMPLATE, 'tool':SKIDL, 'aliases':Alias({'RP2040_Zero'}), 'ref_prefix':'U', 'fplist':None, 'footprint':'a7s:RP2040_Zero', 'keywords':None, 'description':'', 'datasheet':None, 'pins':[
            Pin(num='5V',name='5V',func=pin_types.PASSIVE),
            Pin(num='GND',name='GND',func=pin_types.PASSIVE),
            Pin(num='3V3',name='3V3',func=pin_types.PASSIVE),
            Pin(num='GP29',name='GP29',func=pin_types.PASSIVE),
            Pin(num='GP28',name='GP28',func=pin_types.PASSIVE),
            Pin(num='GP27',name='GP27',func=pin_types.PASSIVE),
            Pin(num='GP26',name='GP26',func=pin_types.PASSIVE),
            Pin(num='GP15',name='GP15',func=pin_types.PASSIVE),
            Pin(num='GP14',name='GP14',func=pin_types.PASSIVE),
            Pin(num='GP0',name='GP0',func=pin_types.PASSIVE),
            Pin(num='GP1',name='GP1',func=pin_types.PASSIVE),
            Pin(num='GP2',name='GP2',func=pin_types.PASSIVE),
            Pin(num='GP3',name='GP3',func=pin_types.PASSIVE),
            Pin(num='GP4',name='GP4',func=pin_types.PASSIVE),
            Pin(num='GP5',name='GP5',func=pin_types.PASSIVE),
            Pin(num='GP6',name='GP6',func=pin_types.PASSIVE),
            Pin(num='GP7',name='GP7',func=pin_types.PASSIVE),
            Pin(num='GP8',name='GP8',func=pin_types.PASSIVE),
            Pin(num='GP9',name='GP9',func=pin_types.PASSIVE),
            Pin(num='GP10',name='GP10',func=pin_types.PASSIVE),
            Pin(num='GP11',name='GP11',func=pin_types.PASSIVE),
            Pin(num='GP12',name='GP12',func=pin_types.PASSIVE),
            Pin(num='GP13',name='GP13',func=pin_types.PASSIVE)] }),
        Part(**{ 'name':'SW_Push', 'dest':TEMPLATE, 'tool':SKIDL, 'aliases':Alias({'SW_Push'}), 'ref_prefix':'SW', 'fplist':[''], 'footprint':'Button_Switch_THT:SW_PUSH_6mm', 'keywords':'switch normally-open pushbutton push-button', 'description':'Push button switch, generic, two pins', 'datasheet':'~', 'pins':[
            Pin(num='1',name='1',func=pin_types.PASSIVE),
            Pin(num='2',name='2',func=pin_types.PASSIVE)], 'unit_defs':[] }),
        Part(**{ 'name':'Conn_01x05', 'dest':TEMPLATE, 'tool':SKIDL, 'aliases':Alias({'Conn_01x05'}), 'ref_prefix':'J', 'fplist':[''], 'footprint':'Connector_PinHeader_2.54mm:PinHeader_1x05_P2.54mm_Vertical', 'keywords':'connector', 'description':'Generic connector, single row, 01x05, script generated (kicad-library-utils/schlib/autogen/connector/)', 'datasheet':'~', 'pins':[
            Pin(num='1',name='Pin_1',func=pin_types.PASSIVE,unit=1),
            Pin(num='2',name='Pin_2',func=pin_types.PASSIVE,unit=1),
            Pin(num='3',name='Pin_3',func=pin_types.PASSIVE,unit=1),
            Pin(num='4',name='Pin_4',func=pin_types.PASSIVE,unit=1),
            Pin(num='5',name='Pin_5',func=pin_types.PASSIVE,unit=1)], 'unit_defs':[] }),
        Part(**{ 'name':'Conn_01x04', 'dest':TEMPLATE, 'tool':SKIDL, 'aliases':Alias({'Conn_01x04'}), 'ref_prefix':'J', 'fplist':[''], 'footprint':'Connector_PinHeader_2.54mm:PinHeader_1x04_P2.54mm_Vertical', 'keywords':'connector', 'description':'Generic connector, single row, 01x04, script generated (kicad-library-utils/schlib/autogen/connector/)', 'datasheet':'~', 'pins':[
            Pin(num='1',name='Pin_1',func=pin_types.PASSIVE,unit=1),
            Pin(num='2',name='Pin_2',func=pin_types.PASSIVE,unit=1),
            Pin(num='3',name='Pin_3',func=pin_types.PASSIVE,unit=1),
            Pin(num='4',name='Pin_4',func=pin_types.PASSIVE,unit=1)], 'unit_defs':[] }),
        Part(**{ 'name':'Conn_01x03', 'dest':TEMPLATE, 'tool':SKIDL, 'aliases':Alias({'Conn_01x03'}), 'ref_prefix':'J', 'fplist':[''], 'footprint':'Connector_PinHeader_2.54mm:PinHeader_1x03_P2.54mm_Vertical', 'keywords':'connector', 'description':'Generic connector, single row, 01x03, script generated (kicad-library-utils/schlib/autogen/connector/)', 'datasheet':'~', 'pins':[
            Pin(num='1',name='Pin_1',func=pin_types.PASSIVE,unit=1),
            Pin(num='2',name='Pin_2',func=pin_types.PASSIVE,unit=1),
            Pin(num='3',name='Pin_3',func=pin_types.PASSIVE,unit=1)], 'unit_defs':[] }),
        Part(**{ 'name':'Conn_01x18', 'dest':TEMPLATE, 'tool':SKIDL, 'aliases':Alias({'Conn_01x18'}), 'ref_prefix':'J', 'fplist':[''], 'footprint':'a7s:FLIPPER-GPIO-18', 'keywords':'connector', 'description':'Generic connector, single row, 01x18, script generated (kicad-library-utils/schlib/autogen/connector/)', 'datasheet':'~', 'pins':[
            Pin(num='1',name='Pin_1',func=pin_types.PASSIVE,unit=1),
            Pin(num='10',name='Pin_10',func=pin_types.PASSIVE,unit=1),
            Pin(num='11',name='Pin_11',func=pin_types.PASSIVE,unit=1),
            Pin(num='12',name='Pin_12',func=pin_types.PASSIVE,unit=1),
            Pin(num='13',name='Pin_13',func=pin_types.PASSIVE,unit=1),
            Pin(num='14',name='Pin_14',func=pin_types.PASSIVE,unit=1),
            Pin(num='15',name='Pin_15',func=pin_types.PASSIVE,unit=1),
            Pin(num='16',name='Pin_16',func=pin_types.PASSIVE,unit=1),
            Pin(num='17',name='Pin_17',func=pin_types.PASSIVE,unit=1),
            Pin(num='18',name='Pin_18',func=pin_types.PASSIVE,unit=1),
            Pin(num='2',name='Pin_2',func=pin_types.PASSIVE,unit=1),
            Pin(num='3',name='Pin_3',func=pin_types.PASSIVE,unit=1),
            Pin(num='4',name='Pin_4',func=pin_types.PASSIVE,unit=1),
            Pin(num='5',name='Pin_5',func=pin_types.PASSIVE,unit=1),
            Pin(num='6',name='Pin_6',func=pin_types.PASSIVE,unit=1),
            Pin(num='7',name='Pin_7',func=pin_types.PASSIVE,unit=1),
            Pin(num='8',name='Pin_8',func=pin_types.PASSIVE,unit=1),
            Pin(num='9',name='Pin_9',func=pin_types.PASSIVE,unit=1)], 'unit_defs':[] }),
        Part(**{ 'name':'TestPoint', 'dest':TEMPLATE, 'tool':SKIDL, 'aliases':Alias({'TestPoint'}), 'ref_prefix':'TP', 'fplist':[''], 'footprint':'TestPoint:TestPoint_Pad_D1.0mm', 'keywords':'test point tp', 'description':'test point', 'datasheet':'~', 'pins':[
            Pin(num='1',name='1',func=pin_types.PASSIVE,unit=1)], 'unit_defs':[] })])
