skitzo2000/cyberdecks/(commit log)

2026-05-20 Initial commit: cyberdeck component buyer's guides (2026)
    Six-part research set covering compute, displays, input, power,
    networking/radio, and chassis — plus a workshop build guide and
    top-level index.
2026-05-20 Split workshop monolith into modular workshop series
    Replace single workshop-build.md with workshops/ subdirectory so builders
    attend only the sessions covering their chosen upgrades:
    - 00-basic-build: Pi Zero 2 W + 4.2"/5.83" e-paper + PiSugar 3 + BT kb
    - 01-battery-18650: custom 2-cell pack upgrade (replaces PiSugar 3)
    - 02-bbq20-clamshell: integrated BBQ20 + custom QMK carrier + clamshell
    with print-in-place PETG hinge (cigar-box chassis documented as
    non-kit alternative)
    - 03-radio-capstone: CC1101 socket, spare LoRa header, USB-A for SDR
    - README: workshop index, cost ladder, $125 cap for maxed mono build
    Maxed mono lands at ~$121; color-screen tier is called out as a
    ~$150 premiu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
2026-05-20 Restructure workshops: precursor + main build + capstone
    Reframe the series so battery and keyboard are precursor sessions that
    builders skip entirely if they want the off-the-shelf path (PiSugar 3,
    BT keyboard). The basic-build workshop is gone; in its place a
    mandatory "main deck build" integrates whatever battery + keyboard you
    brought, and radio infrastructure is now built into that session as a
    core design principle rather than a later add-on.
    - workshops/00-basic-build.md → deleted (split into 02 base + 03 main)
    - workshops/02-bbq20-clamshell.md → renamed 02-bbq20-base.md;
    reframed as building only the clamshell base (lid is W03)
    - workshops/03-radio-capstone.md → renamed 04-r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
2026-05-20 Add BBQ20 keyboard module → RP2040 USB QMK daughterboard research
    BBQ20-DAUGHTERBOARD.md documents the 34-pin 0.5mm-pitch FFC pinout,
    RP2040 GPIO map, trackpad subsystem (1.8V I2C @ 0x3B), backlight
    driver, and full daughterboard BOM (LDOs, level shifters, FET,
    connector) for builders re-spinning a Solder-Party-equivalent
    carrier with raw BB Classic keyboard modules.
    refs/ captures the upstream Solder Party schematic (CERN-OHL v1.2)
    that the pinout was extracted from, for offline traceability.
    [keyboard.kicad_sch, main.kicad_sch]
2026-05-21 Add radio header board: 4-slot universal cyberdeck daughter-PCB
    Design doc for the radio carrier that mounts on the Pi 40-pin GPIO via
    14 mm stacking header (no blocking — next HAT stacks on top) and exposes
    four cheap-radio slots:
    A. CC1101 sub-GHz 1×8 socket (fixed, "always there" radio)
    B. HopeRF RFM95W/RFM69HCW 16-pin SMD castellated landing
    C. Universal 1×9 header, Adafruit LoRa Bonnet pin-compatible
    (SX127x, SX126x, ESP-01, HC-12 via UART_BYPASS jumper)
    D. nRF24L01+ 2×4 socket
    Master kill: SS-12F44 edge-mount slide switch on the 5V JST-PH input,
    green/blue LEDs indicate 5V + 3V3 rails. AP2112K-3.3 LDO supplies the
    radio rail isolated from the Pi's own 3V3 (avoids Lo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
2026-05-21 Pivot radio header board to slim pogo-pin two-piece architecture
    The v1 design used a 14 mm extra-tall stacking GPIO header (Adafruit
    2223) which added ~22 mm to the Pi+HAT vertical stack — too thick for
    a slab cyberdeck. Pivot to a PiSugar-3-style mount: a thin pogo-pin
    adapter (RHB-Pogo) snaps onto the BACK of the Pi via spring-loaded
    contacts on the GPIO solder-pad footprint, and a separate radio
    carrier (RHB-Carrier) lives elsewhere in the chassis connected by a
    24-pin 0.5 mm pitch FFC ribbon.
    Mechanical wins:
    - Pi GPIO header on TOP is mechanically untouched — e-paper or any
    other HAT mounts directly at the standard ~10 mm stack height.
    - RHB-Pogo adds only ~4 mm under the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
2026-06-19 Add A7S cyberdeck backplane (Radxa Cubie A7S radio/RP2040/TFT/Flipper shield)
    Hand-solder THT shield for the Radxa Cubie A7S: 2x '8+1' radio sockets
    (nRF24/CC1101/CC2500) on SPI1, RP2040-Zero input MCU, 2.8" ILI9341 TFT+touch,
    real two-connector Flipper GPIO header. SKiDL netlist + pcbnew board +
    freerouting. Schematic verified; layout is a routed WIP for human refinement.
    Flipper footprints from kbembedded/flipper-gpio-eda (BSD-2-Clause).
    [a7s_backplane.kicad_pcb, a7s_backplane_routed.kicad_pcb]
2026-06-19 backplane: add shield + full-deck BOMs (sourcing links, no prices)
    BOM-SHIELD.md - PCB parts from the netlist (all-THT)
    BOM-DECK.md - full system (A7S, power, radios, inputs, chassis)
    Mark the old inline BACKPLANE-DESIGN.md BOM as superseded; link both from README.
2026-06-19 backplane: purge stale/confusing files; single canonical board
    Remove HANDOFF.md, STATUS.md, _routed duplicate, DRC/scratch outputs, KiCad
    lock/.prl files, 3D placeholder. Old §7 BOM table -> links to BOM-SHIELD/DECK.
    Add .gitignore so build scratch + lock files stay out.
    [a7s_backplane_routed.kicad_pcb]
2026-06-19 backplane: README — author notes (radio placement intent, IO rationale)
2026-06-19 backplane: README — disambiguate the 4 headers (radios 8+1 backside vs Flipper 1x8+1x10 front)
2026-06-19 backplane: add 3D render previews (real screen + RP2040-Zero STEP); embed in README
    Front: 2.8" TFT + buttons. Back: RP2040-Zero, radios standing, power.
    Rough render via kicad-cli + real STEP models. 3D working files gitignored.
2026-06-19 backplane: headers to back, Flipper female socket, inputs as solder pads; exploded assembly render with A7S; drop old half-view renders
    [a7s_backplane.kicad_pcb]
2026-06-19 backplane: render — J12 as female socket, J8/J10/J11 as bare solder pads (matches design)
2026-06-19 backplane: render — flip A7S right-side-up (GPIO pins up; backplane mates from above)
2026-06-19 backplane: nicer assembly render (smooth-shaded, anti-aliased)
2026-06-19 backplane: clean kicad-cli renders (top deck-face + underside); add underside view, drop FreeCAD artifacts
2026-06-19 backplane: underside render — drop fake radio-module placeholders, show real sockets
2026-06-19 backplane: right-handed layout (A7S inverted, USB-C left); radios 90deg top-right; routed 0-unconnected; new renders
    [a7s_backplane.kicad_pcb]
2026-06-20 backplane: validated radio spacing (6.3mm module clearance), re-routed 0-unconnected; board-only renders + module keep-out on Dwgs.User
    [a7s_backplane.kicad_pcb]
2026-06-20 backplane: top render — see-through TFT, connector aligned to J3 header
2026-07-02 kicad schematic
    [a7s_backplane.bak.kicad_pcb]
2026-07-08 V2 schematic update
    [a7s_backplane.bak.kicad_pcb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]
2026-07-11 v2 PCB
    [a7s_backplane.bak.kicad_pcb, a7s_backplane.kicad_pcb, a7s_backplane.kicad_sch, a7s_backplane_hdrfix.kicad_pcb, a7s_backplane_place.kicad_pcb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]
2026-07-11 v2 cleanup
    [a7s_backplane.kicad_pcb, a7s_backplane_hdrfix.kicad_pcb, a7s_backplane_place.kicad_pcb, a7s_backplane_v2.kicad_pcb]
2026-07-12 v2 silkscreens
    [a7s_backplane_routed-B_Cu.gbl, a7s_backplane_routed-B_Mask.gbs, a7s_backplane_routed-B_Silkscreen.gbo, a7s_backplane_routed-Edge_Cuts.gm1, a7s_backplane_routed-F_Cu.gtl, a7s_backplane_routed-F_Mask.gts, a7s_backplane_routed-F_Silkscreen.gto, a7s_backplane_routed-NPTH-drl_map.gbr]
