skitzo2000/cyberdecks/(notices)

Notices in the files:
radio-header-board/refs/SmartRC-CC1101-README.md:
License: MIT
